watsonboyett/marvin/README.md

# Marvin

A chronically depressed and often bored robot that performs mundane tasks, despite being capable of great things...
