watsonboyett/marvin/EnviroTron/hardware/Part Selection.md

## MCU

* D1 Mini Pro - $5, 11 DIO, 1 AIO [web](https://www.wemos.cc/product/d1-mini-pro.html)

## Temp/Humidity

* SHT21 - $9, I2C, 0.5C/2%RH accuracy
* SHT25 - $14, I2C, 0.2C/1.8%RH accuracy
* Si7013 - $4, I2C, 0.4C/3%RH accuracy

## Light

* LTR-329ALS-01 - $1, I2C, Separate Visible/IR channels
* TSL45315CL - $2, I2C, 
* PDV-P9203 - $2, Analog, 

## PIR

* EKMC1601112 - $12, Standard range/angle
* EKMC1603112 - $13, Long range, standard angle
* AMN34111 - $23, Wall range/angle

## Pressure

* LPS22HBTR - $4, I2C, high accuracy, decent range
* ICM-20789 - $?, I2C, 1hPa, 300hPa - 1100hPa (includes gyroscope and accelerometer)

## Sound 

* (MIC) SPM0404HE5H-PB - $4
* (MIC) CMA-4544PF-W - $2
* (MIC) SPU0410HR5H-PB - $1
* (AMP) MCP6022T-I/ST - $2
* http://electronics.stackexchange.com/a/16596/83463
* http://electronics.stackexchange.com/a/58703/83463

## Air Quality

* AS-MLV-P2 - $25, CO/
* SGP30 - $?, MO Gas (CO2 Equivalent)

## Vibration/Acceleration

* D7S-A0001 - $30, 3 Axis
