watsonboyett/marvin/EnviroTron/hardware/archive/EnviroTron v1C - Schematic.pdf

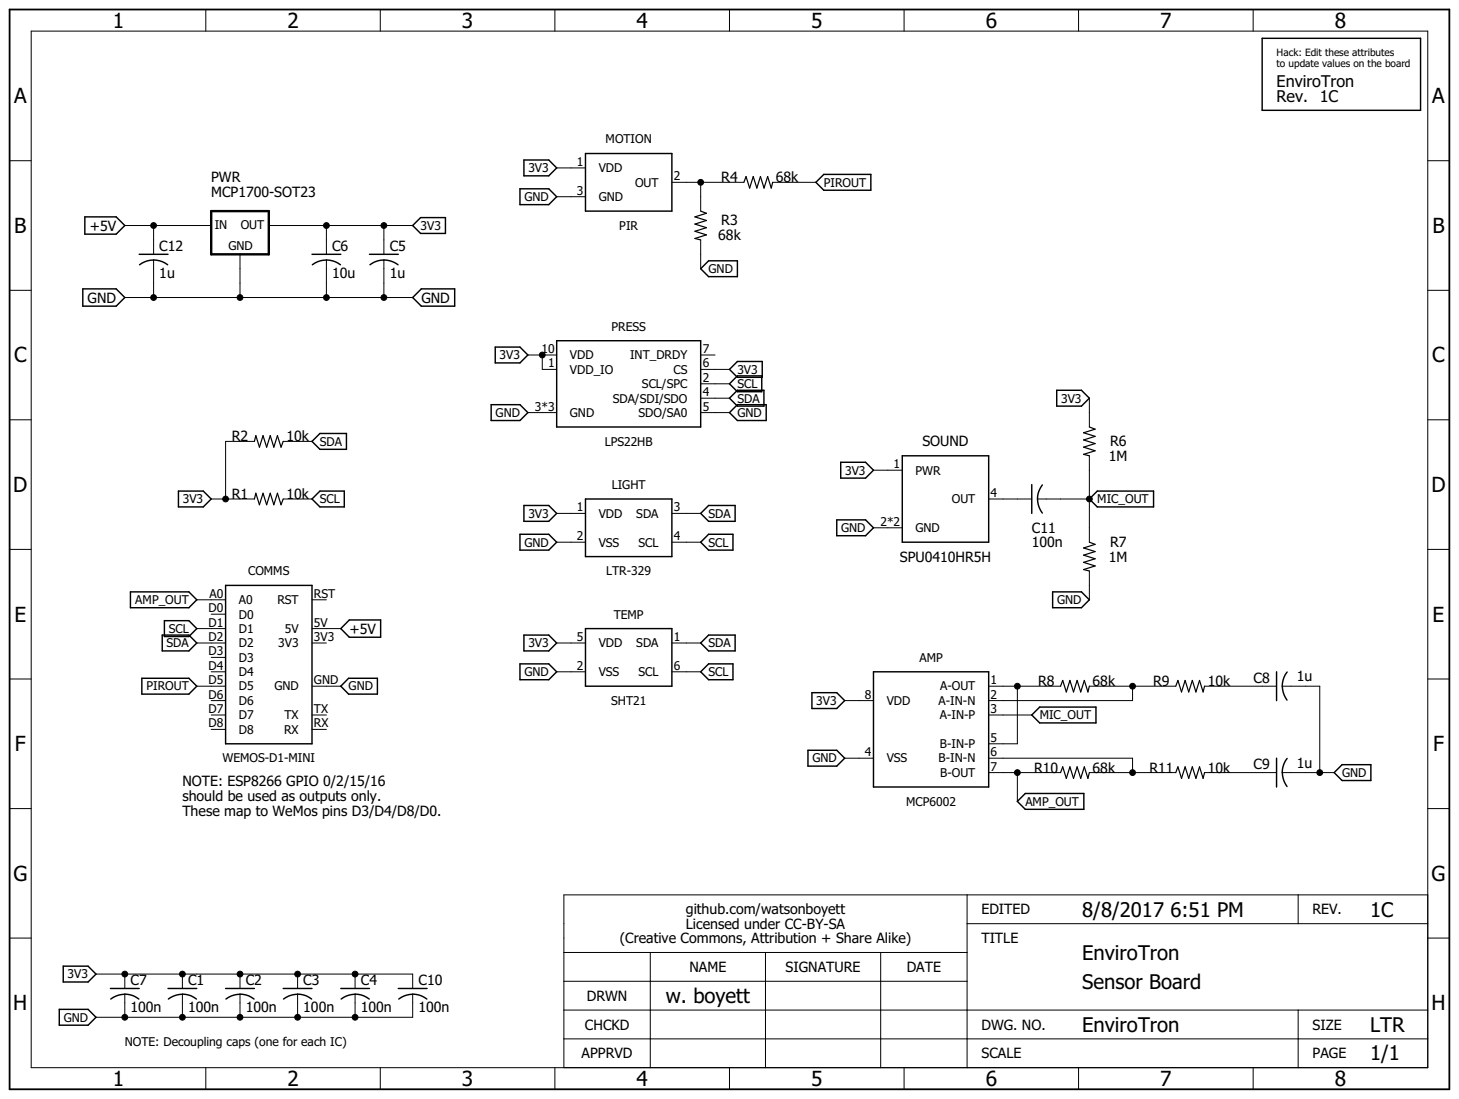
[picture p1: page 1]

Hack: Edit these attributes
to update values on the board
EnviroTron
Rev. 1C

NOTE: ESP8266 GPIO 0/2/15/16
should be used as outputs only. These map to WeMos pins D3/D4/D8/D0.

github.com/watsonboyett
Licensed under CC-BY-SA

(Creative Commons, Attribution + Share Alike)

NAME | SIGNATURE | DATE

DRWN | w. boyett
CHCKD | | | | EnviroTron | SIZE LTR

NOTE: Decoupling caps (one for each IC)

APPRVD | | | | SCALE | PAGE 1/1
