watsonboyett/marvin/EnviroTron/hardware/archive/EnviroTron v1C - Values.pdf

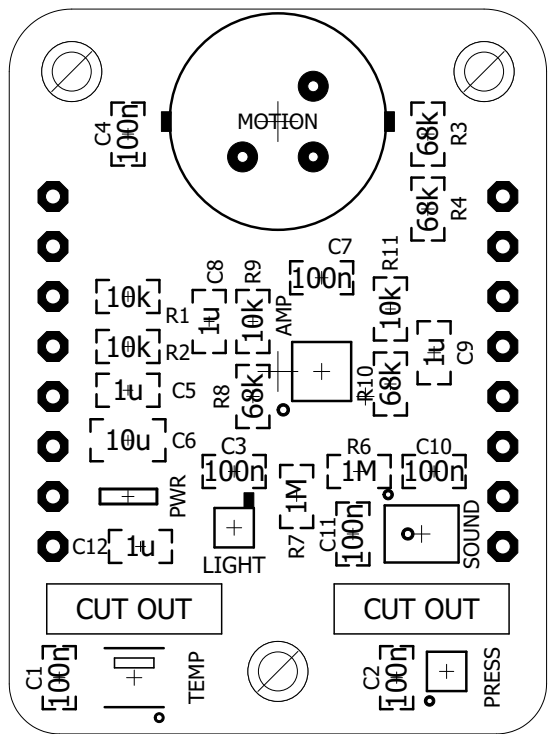
[picture p2: page 1]
