watsonboyett/marvin/EnviroTron/hardware/EnviroTron32.brd

## EAGLE design EnviroTron/hardware/EnviroTron32.brd (2019-10-10)

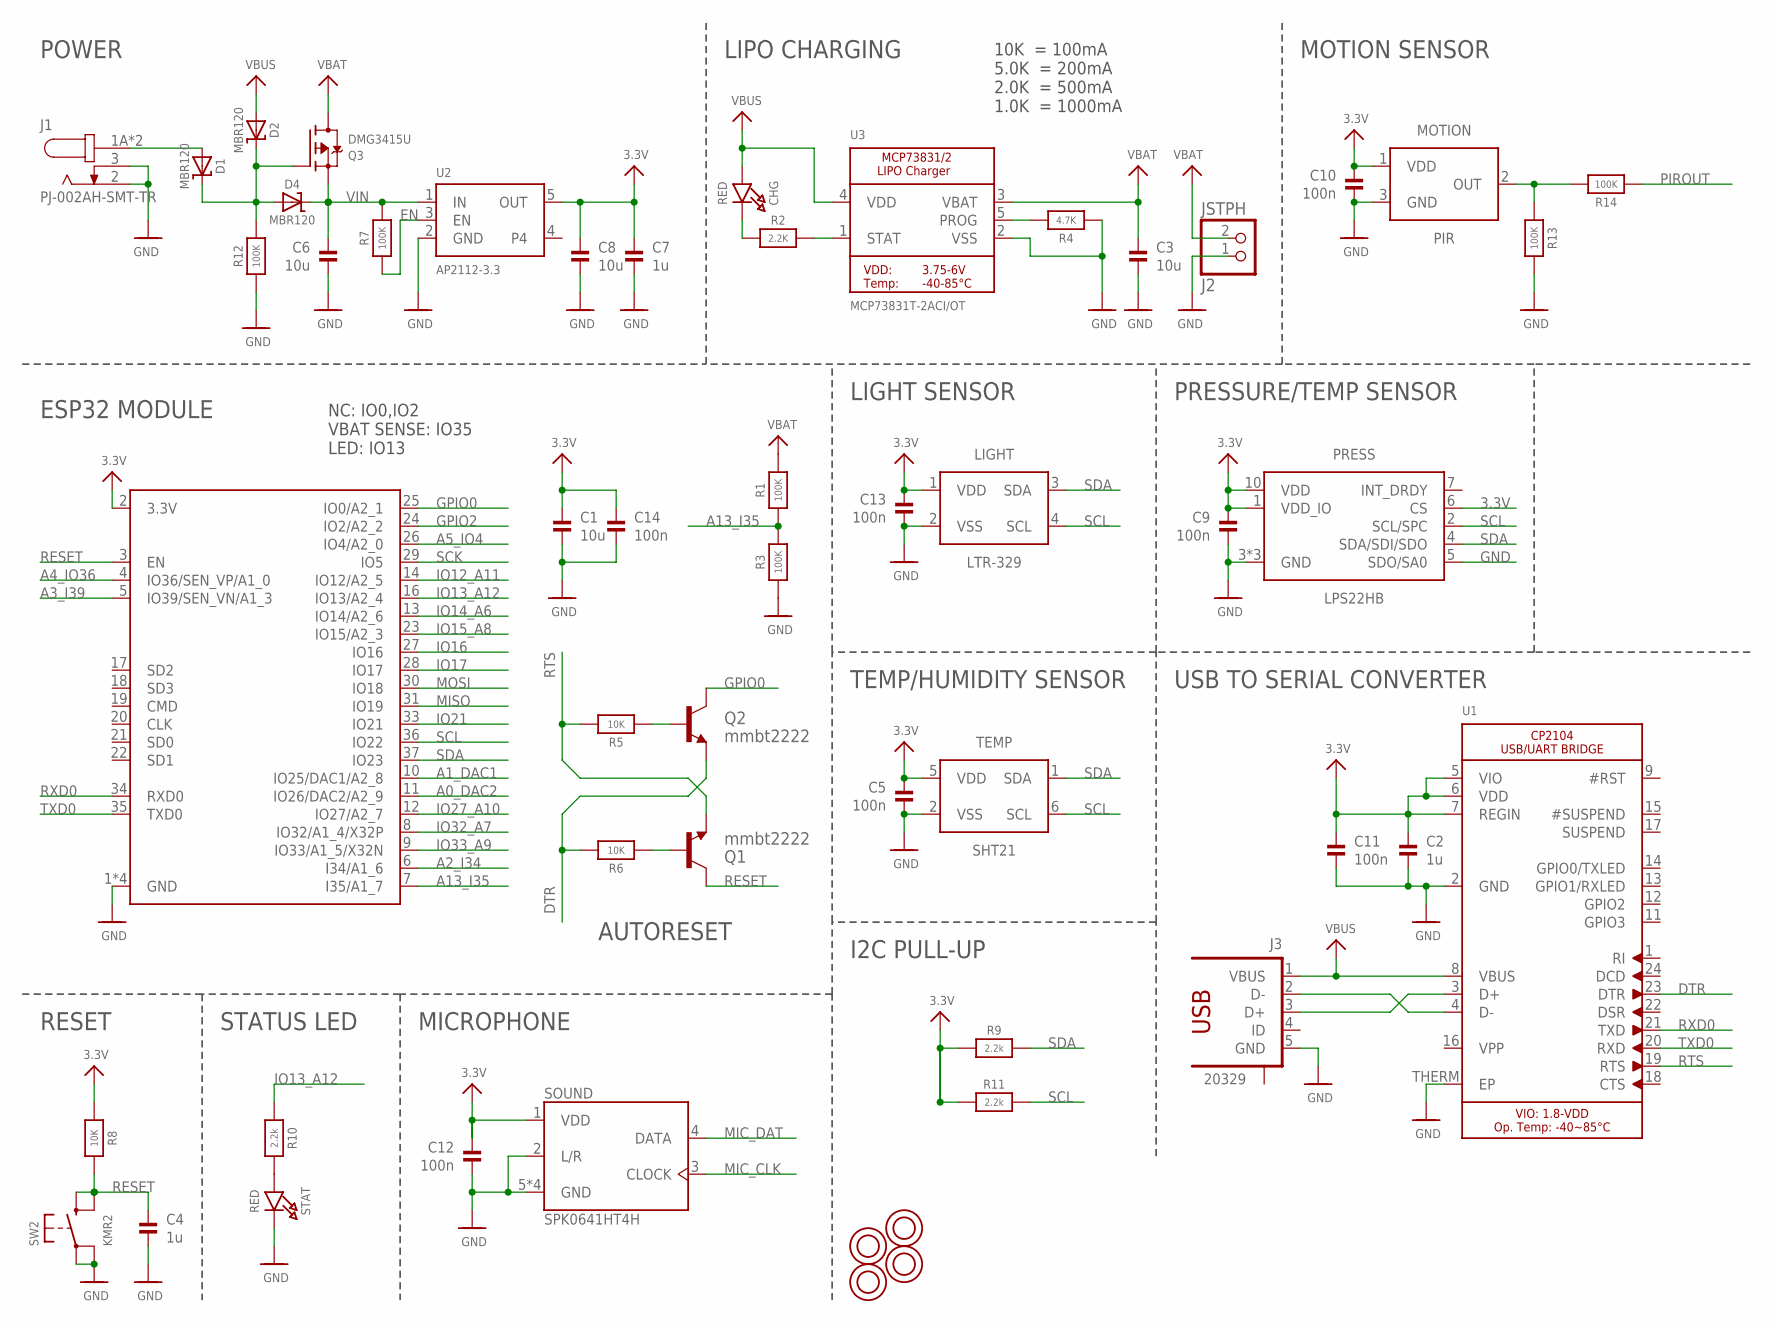
[picture p3: schematic EnviroTron32.sch]

Parts:
C1, C3, C6, C8: 10u; 0805-NO
C2: 1u; _0603
C4, C7: 1u; 0603-NO
C5, C9, C10, C11, C12, C13, C14: 100n; _0603
CHG: RED; CHIPLED_0805_NOOUTLINE
D1, D2, D4: MBR120; SOD-123
J1: PJ-002AH-SMT-TR; CUI_PJ-002AH-SMT-TR
J2: JSTPH; JSTPH2
J3: 20329; USB-10118192-0001LF
LIGHT: LTR-329; CHIPLED4
MOTION: PIR; CAN3
PRESS: LPS22HB; HLGA-10L
Q1, Q2: mmbt2222; SOT23-3
Q3: DMG3415U; SOT23-R
R1, R3, R7, R12, R13, R14: 100K; 0603-NO
R2: 2.2K; 0603-NO
R4: 4.7K; 0603-NO
R5, R6, R8: 10K; 0603-NO
R9, R10, R11: 2.2k; 0603-NO
SOUND: SPK0641HT4H; SPK0641HT4H-1
STAT: RED; CHIPLED_0805_NOOUTLINE
SW2: KMR2; BTN_KMR2_4.6X2.8
TEMP: SHT21; SHT2X-DFN6
U1: CP2104; QFN24_4MM_SMSC
U2: AP2112-3.3; SOT23-5
U3: MCP73831T-2ACI/OT; SOT23-5
U$17, U$31, U$32, U$34: TERM-7774
X2: ESP32_WROOM32_SKINNY; WROOM32_SKINNY

Connections:
3.3V: C1.1, C2.1, C5.1, C7.1, C8.1, C9.1, C10.1, C11.1, C12.1, C13.1, C14.1, LIGHT.1 (VDD), MOTION.1 (VDD), PRESS.1 (VDD_IO), PRESS.6 (CS), PRESS.10 (VDD), R8.1, R9.1, R11.1, SOUND.1 (VDD), TEMP.5 (VDD), U1.5 (VIO), U1.6 (VDD), U1.7 (REGIN), U2.5 (OUT), X2.2 (3.3V)
A0_DAC2: X2.11 (IO26/DAC2/A2_9)
A1_DAC1: X2.10 (IO25/DAC1/A2_8)
A2_I34: X2.6 (I34/A1_6)
A3_I39: X2.5 (IO39/SEN_VN/A1_3)
A4_IO36: X2.4 (IO36/SEN_VP/A1_0)
A5_IO4: X2.26 (IO4/A2_0)
A13_I35: R1.1, R3.2, X2.7 (I35/A1_7)
DCIN: D1.A, J1.1A (1), J1.1B (1)
DTR: Q2.2 (E), R6.2, U1.23 (DTR)
EN: R7.1, U2.3 (EN)
GND: C1.2, C2.2, C3.2, C4.2, C5.2, C6.2, C7.2, C8.2, C9.2, C10.2, C11.2, C12.2, C13.2, C14.2, J1.2, J1.3, J2.1, J3.5 (GND), LIGHT.2 (VSS), MOTION.3 (GND), PRESS.3 (GND), PRESS.5 (SDO/SA0), PRESS.8 (GND), PRESS.9 (GND), R3.1, R4.1, R12.1, R13.2, SOUND.2 (L/R), SOUND.5 (GND), SOUND.6 (GND), SOUND.7 (GND), SOUND.8 (GND), STAT.C, SW2.A, SW2.A' (P1), TEMP.2 (VSS), U1.2 (GND), U1.THERM (EP), U2.2 (GND), U3.2 (VSS), X2.1 (GND), X2.15 (GND), X2.38 (GND), X2.P$1 (GND)
GPIO0: Q2.3 (C), X2.25 (IO0/A2_1)
GPIO2: X2.24 (IO2/A2_2)
IO12_A11: X2.14 (IO12/A2_5)
IO13_A12: R10.1, X2.16 (IO13/A2_4)
IO14_A6: X2.13 (IO14/A2_6)
IO15_A8: X2.23 (IO15/A2_3)
IO16: X2.27 (IO16)
IO17: X2.28 (IO17)
IO21: X2.33 (IO21)
IO27_A10: X2.12 (IO27/A2_7)
IO32_A7: X2.8 (IO32/A1_4/X32P)
IO33_A9: X2.9 (IO33/A1_5/X32N)
MIC_CLK: SOUND.3 (CLOCK)
MIC_DAT: SOUND.4 (DATA)
MISO: X2.31 (IO19)
MOSI: X2.30 (IO18)
unnamed: CHG.C, R2.1
unnamed: J3.3 (D+), U1.3 (D+)
unnamed: R2.2, U3.1 (STAT)
unnamed: R4.2, U3.5 (PROG)
unnamed: R10.2, STAT.A
unnamed: J3.2 (D-), U1.4 (D-)
unnamed: D1.C, D2.C, D4.A, Q3.1 (G), R12.2
unnamed: MOTION.2 (OUT), R13.1, R14.2
unnamed: Q1.1 (B), R6.1
unnamed: Q2.1 (B), R5.1
PIROUT: R14.1
RESET: C4.1, Q1.3 (C), R8.2, SW2.B (S), SW2.B' (S1), X2.3 (EN)
RTS: Q1.2 (E), R5.2, U1.19 (RTS)
RXD0: U1.21 (TXD), X2.34 (RXD0)
SCK: X2.29 (IO5)
SCL: LIGHT.4 (SCL), PRESS.2 (SCL/SPC), R11.2, TEMP.6 (SCL), X2.36 (IO22)
SDA: LIGHT.3 (SDA), PRESS.4 (SDA/SDI/SDO), R9.2, TEMP.1 (SDA), X2.37 (IO23)
TXD0: U1.20 (RXD), X2.35 (TXD0)
VBAT: C3.1, J2.2, Q3.3 (D), R1.2, U3.3 (VBAT)
VBUS: CHG.A, D2.A, J3.1 (VBUS), U1.8 (VBUS), U3.4 (VDD)
VIN: C6.1, D4.C, Q3.2 (S), R7.2, U2.1 (IN)

Notes on the sheet:
POWER
RESET
10K = 100mA 5.0K = 200mA 2.0K = 500mA 1.0K = 1000mA
USB TO SERIAL CONVERTER
LIPO CHARGING
STATUS LED
ESP32 MODULE
NC: IO0,IO2 VBAT SENSE: IO35 LED: IO13
PRESSURE/TEMP SENSOR
MOTION SENSOR
LIGHT SENSOR
TEMP/HUMIDITY SENSOR
I2C PULL-UP
MICROPHONE
AUTORESET

Board: 4 copper layers, 57 parts (0 on the bottom side), 27 nets, no tracks yet.

Other parts of the board:
U$35, U$43, U$44, U$45: HOLE_4-40
