watsonboyett/marvin/EnviroTron/hardware/EnviroTron.brd

## EAGLE design EnviroTron/hardware/EnviroTron.brd (2019-10-09)

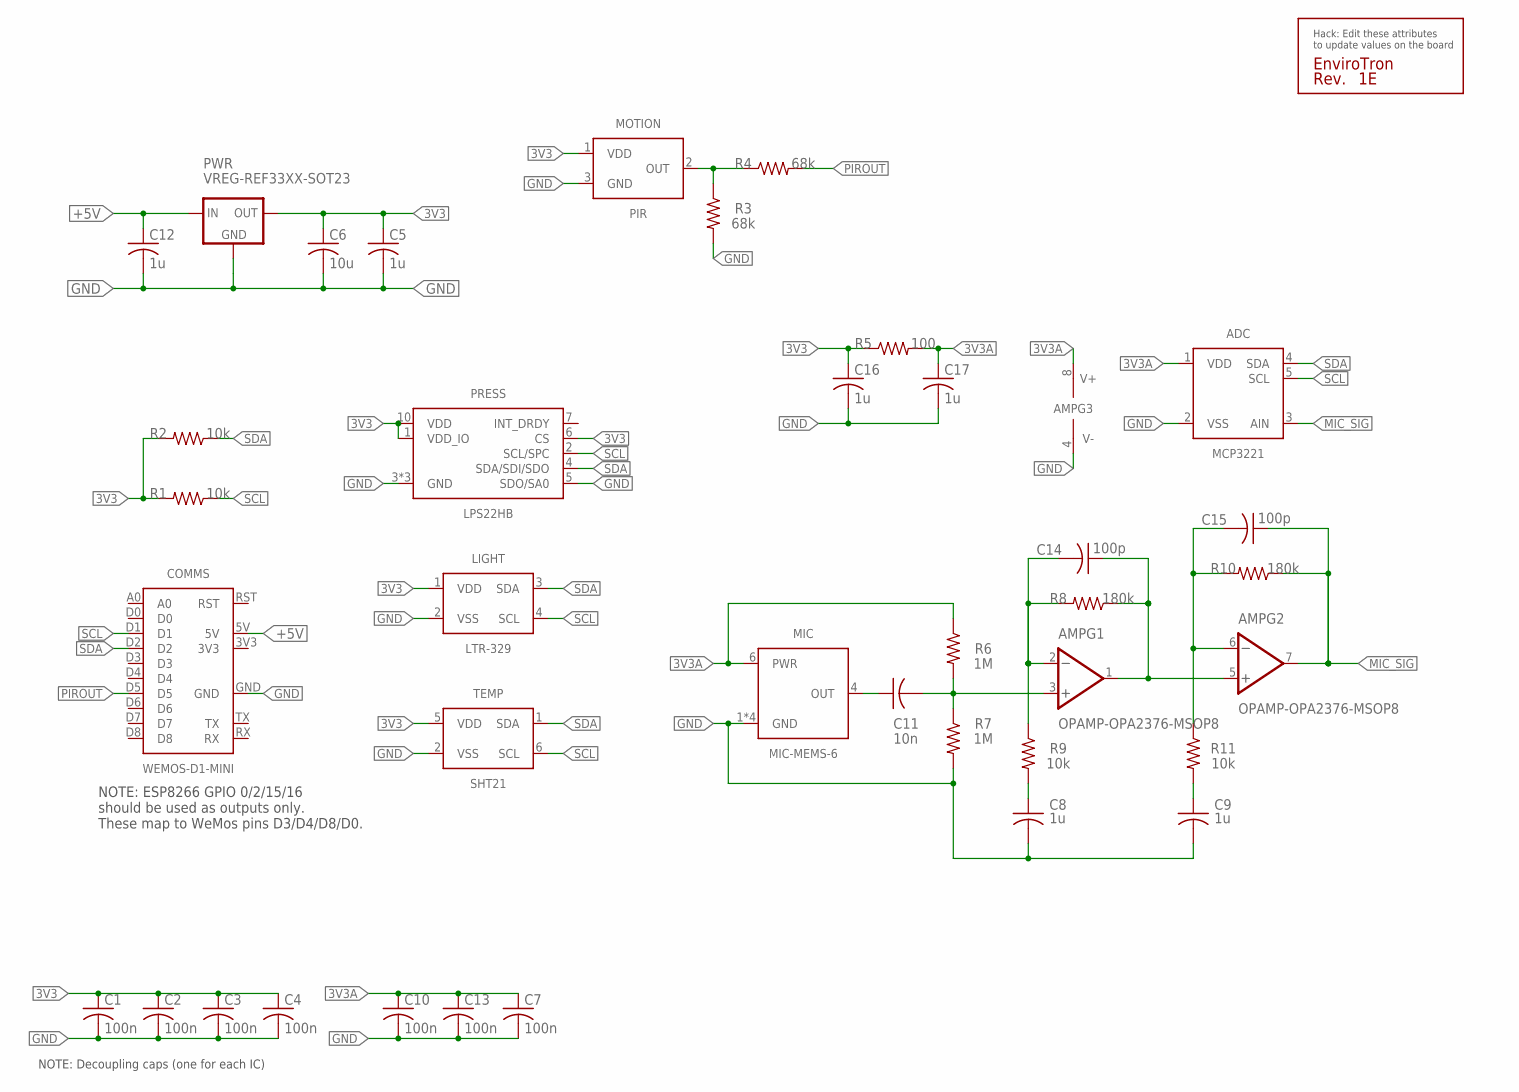
[picture p4: schematic EnviroTron.sch]

Parts:
ADC: MCP3221; SOT23-5
AMP: OPAMP-OPA2376-MSOP8; MSOP-8
C1, C2, C3, C4, C7, C10, C13: 100n; C0603
C5, C8, C9, C12, C16, C17: 1u; C0603
C6: 10u; C0805
C11: 10n; C0603
C14, C15: 100p; C0603
COMMS: WEMOS-D1-MINI
LIGHT: LTR-329; CHIPLED4
MIC: MIC-MEMS-6; DFN-6
MOTION: PIR; CAN3
PRESS: LPS22HB; HLGA-10L
PWR: VREG-REF33XX-SOT23; SOT23-3
R1, R2, R9, R11: 10k; R0603
R3, R4: 68k; R0603
R5: 100; R0603
R6, R7: 1M; R0603
R8, R10: 180k; R0603
TEMP: SHT21; SHT2X-DFN6
U$1: SILK_QC

Connections:
3V3: C1.1, C2.1, C3.1, C4.1, C5.1, C6.1, C16.1, LIGHT.1 (VDD), MOTION.1 (VDD), PRESS.1 (VDD_IO), PRESS.6 (CS), PRESS.10 (VDD), PWR.2 (OUT), R1.2, R2.2, R5.1, TEMP.5 (VDD)
3V3A: ADC.1 (VDD), AMP.8 (V+), C7.1, C10.1, C13.1, C17.1, MIC.6 (PWR), R5.2, R6.1
+5V: C12.1, COMMS.5V, PWR.1 (IN)
GND: ADC.2 (VSS), AMP.4 (V-), C1.2, C2.2, C3.2, C4.2, C5.2, C6.2, C7.2, C8.2, C9.2, C10.2, C12.2, C13.2, C16.2, C17.2, COMMS.GND, LIGHT.2 (VSS), MIC.1 (GND), MIC.2 (GND), MIC.3 (GND), MIC.5 (GND), MOTION.3 (GND), PRESS.3 (GND), PRESS.5 (SDO/SA0), PRESS.8 (GND), PRESS.9 (GND), PWR.3 (GND), R3.2, R7.2, TEMP.2 (VSS)
MIC_OUT: AMP.3 (+IN), C11.2, R6.2, R7.1
MIC_SIG: ADC.3 (AIN), AMP.7 (OUT), C15.1, R10.1
unnamed: AMP.1 (OUT), AMP.5 (+IN), C14.1, R8.1
unnamed: MOTION.2 (OUT), R3.1, R4.1
unnamed: AMP.2 (-IN), C14.2, R8.2, R9.1
unnamed: C8.1, R9.2
unnamed: C11.1, MIC.4 (OUT)
unnamed: AMP.6 (-IN), C15.2, R10.2, R11.1
unnamed: C9.1, R11.2
PIROUT: COMMS.D5, R4.2
SCL: ADC.5 (SCL), COMMS.D1, LIGHT.4 (SCL), PRESS.2 (SCL/SPC), R1.1, TEMP.6 (SCL)
SDA: ADC.4 (SDA), COMMS.D2, LIGHT.3 (SDA), PRESS.4 (SDA/SDI/SDO), R2.1, TEMP.1 (SDA)

Notes on the sheet:
NOTE: Decoupling caps (one for each IC)
NOTE: ESP8266 GPIO 0/2/15/16 should be used as outputs only. These map to WeMos pins D3/D4/D8/D0.

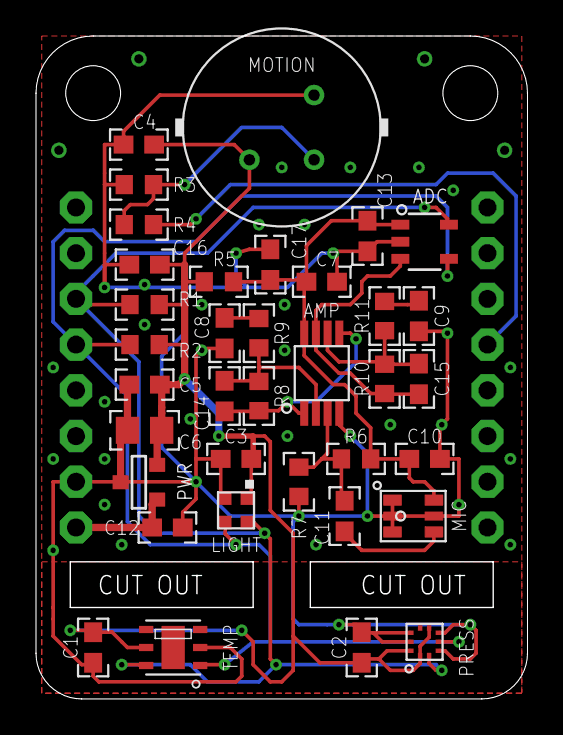
[picture p5: board EnviroTron.brd from above]

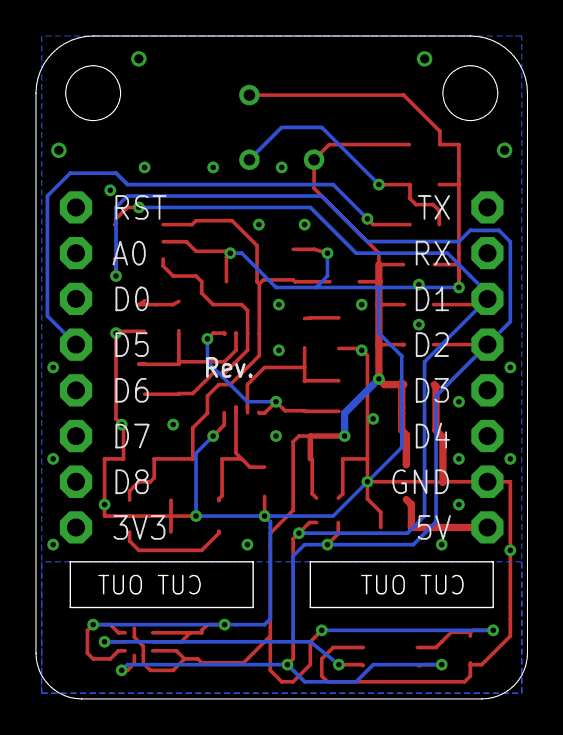
[picture p6: board EnviroTron.brd from below]

Board: 2 copper layers, 27.3 x 36.8 mm, 38 parts (2 on the bottom side), 16 nets.
