watsonboyett/marvin/EnviroTron/firmware/Sensors.h

#pragma once

#include <Arduino.h>

typedef struct
{
  uint32_t sample_count = 0;
  bool motion_inst = 0;
  bool motion_avg = 0;
  float light_inst = 0;
  float light_avg = 0;
  float ir_inst = 0;
  float ir_avg = 0;
  float temp_inst = 0;
  float temp_avg = 0;
  float rel_hum_inst = 0;
  float rel_hum_avg = 0;
  float pres_inst = 0;
  float pres_avg = 0;
  float temp_alt_inst = 0;
  float temp_alt_avg = 0;
  float sound_inst = 0;
  float sound_avg = 0;
  float sound_max = 0;
} SensorData_t;

void SENSORS_Init();

void SENSORS_EnableInterrupts();

void SENSORS_DisableInterrupts();

void SENSORS_Update();

void SENSORS_ClearHoldValues();

SensorData_t SENSORS_GetSensorData();

char * SENSORS_GetInstString();

char * SENSORS_GetAvgString();
