watsonboyett/marvin/EnviroTron/firmware/common.cpp

#include "common.h"

/* Create a string of binary digits based on the input value.
   Input:
       val:  value to convert.
       buff: buffer to write to must be >= sz+1 chars.
       sz:   size of buffer.
   Returns address of string or NULL if not enough space provided.
*/
char * convert_to_binary_string(unsigned int val, char *buff, int sz)
{
    char *pbuff = buff;

    /* Must be able to store one character at least. */
    if (sz < 1) return NULL;

    /* Special case for zero to ensure some output. */
    if (false && val == 0)
    {
        *pbuff++ = '0';
        *pbuff = '\0';
        return buff;
    }

    /* Work from the end of the buffer back. */
    pbuff += sz;
    *pbuff-- = '\0';

    /* For each bit (going backwards) store character. */
    while (val != 0 || sz > 0)
    {
        if (sz-- == 0) return NULL;
        *pbuff-- = ((val & 1) == 1) ? '1' : '0';

        /* Get next bit. */
        val >>= 1;
    }
    return pbuff + 1;
}


float calc_exponential_avg(float current_value, float new_value, float weight)
{
    return weight * new_value + (1 - weight) * current_value;
}
