watsonboyett/marvin/(commit log)

2016-11-06 Added Arduino/Wemos Temperature and Thermostat projects
2016-12-31 Created EnviroTron schematic and board
    [EnviroTron.brd, EnviroTron.sch]
2017-01-10 Cleaned up small layout details
    [EnviroTron.brd, EnviroTron.sch]
2017-01-23 Created Arduino project for Envirotron boards
2017-01-24 Fixed floating CSB pin on MS5607 chip
    [EnviroTron.brd, EnviroTron.sch]
2017-01-25 Implemented SHT21 sensor reading logic and moved PIR input to D8 pin.
2017-04-07 Added sound sensor to EnviroTron board. Swapped to better Pressure sensor.
    [EnviroTron.brd, EnviroTron.sch]
2017-04-07 Added DC blocking cap to mic pre-amp circuit.
    [EnviroTron.brd, EnviroTron.sch]
2017-04-09 Completed initial routing of all signals for new board layout.
    [EnviroTron.brd, EnviroTron.sch]
2017-05-03 Reorganized files into project based structures
    [EnviroTron.brd, EnviroTron.sch]
2017-05-24 Added support for MS5607. Improved support for other sensors.
2017-05-24 Added support for LPS22HB pressure sensor chip.
2017-05-27 Refactored sensor logic into their own files. All sensors seem to be working as they should now.
2017-05-27 Starting to update ThermoBot to use EnviroTron sensor nodes.
2017-05-29 Added support for writing sensor data to influx db
2017-06-11 Added MUX to allow for hardware defined device IDs. Moved PIR input to pin that doesn't affect bootloader operation.
    [EnviroTron.brd, EnviroTron.sch]
2017-06-11 Consolidated all parts to EnviroTron library. Cleaned up schematic and layout.
    [EnviroTron.brd, EnviroTron.sch]
2017-06-11 Updated firmware to move PIR input to D5 pin.
2017-07-16 Improved mic function interface. Improved calibration offsets for temperature sensors.
2017-07-17 Redesigned board so that all components are on one side. Fixed some issues discovered through testing.
    [EnviroTron.brd, EnviroTron.sch]
2017-07-18 Trying to fix spurious reboot issue.
    [firmware.ino]
2017-07-20 Attempting to fix ADC noise by preventing ESP from sleeping.
    [firmware.ino]
2017-08-08 Added 3v3 regulator; finalized layout and BOM
    [EnviroTron v1C - BOM.csv, EnviroTron.brd, EnviroTron.sch]
2017-08-09 Fixed silkscreen name and value placements. Created MFG and archive files for v1C.
    [EnviroTron.brd, EnviroTron.sch]
2017-08-25 Added ADC in place of noisy ESP8266 ADC. Switched to precision reference for voltage source.
    [EnviroTron v1D - BOM.csv, EnviroTron.brd, EnviroTron.sch]
2017-12-10 Changed PIR input pin.
2017-12-11 Added support for MSP3221 ADC for MIC sensor. Added common function/macros file and cleaned up existing usages.
2017-12-12 Fixed some bugs related to the mic input
    [MicAdc.cpp, firmware.ino]
2017-12-21 Refactored mic and ADC logic into separate modules.
2018-01-07 Changed mic to new part. Added Pi filter for analog voltage rail.
    [EnviroTron.brd, EnviroTron.sch]
2018-01-09 Added PI filter to create analog voltage rail. Increased mic amp gain. Replaced mic with lower noise device.
    [EnviroTron.brd, EnviroTron.sch]
2019-10-09 Checking in current state before starting totally new hardware version
    [EnviroTron.brd]
2019-10-10 Started V2 of EnviroTron
    [EnviroTron32.brd, EnviroTron32.sch]
