watsonboyett/marvin/(notices)

Notices in the files:
EnviroTron/hardware/EnviroTron.sch:
CONTACT_ADDRESS: Licensed under CC-BY-SA
CONTACT_PHONE: (Creative Commons, Attribution + Share Alike)
